an-sy/fhnw-iot-project-media-controller/05-Praesentation-Slides/IoT_Praesentation_Slides.pdf

# Senior Media Controller

# Iot-Projekt HS19

## Anas Syed, Ravindra Asirvatham

# Usecase

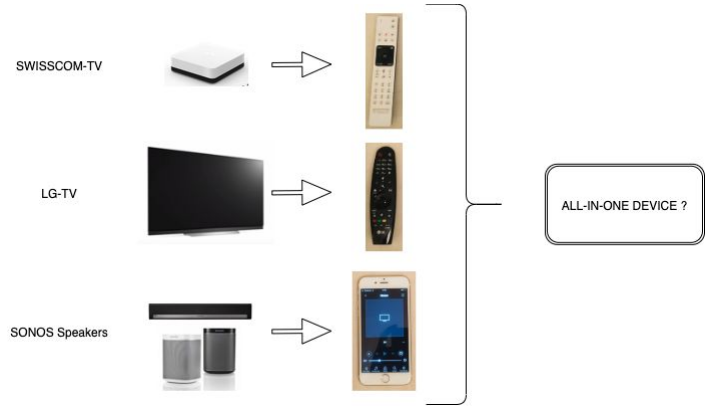
[picture p9: figure]

# Senior, 78, möchte seine Swisscom-TV und Sonos Lautsprecher Anlage mit einem einzigen Gerät bedienen

können.

### Senior Media Controller, IoT Project, HS19 by Anas Syed & Ravindra Asirvatham

# Referencemodel

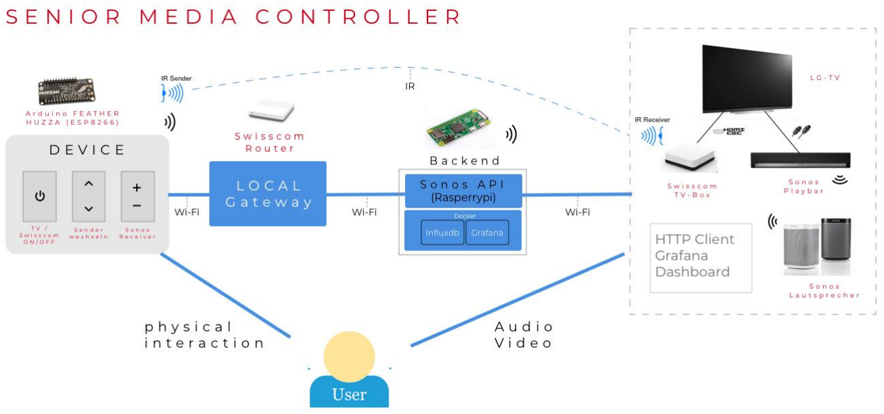
[picture p10: figure]

# Interface documentation

Sonos API Host: Sonos API Server Port: 5005 | | Contenttype: application/x-www-form-urlencoded requestBody: 'iotdevicelogs,method=changeVolume,status=ok value=20'
VALUE | = Volume

## GET /Fernsehzimmer/volume/VALUE

# IR Swisscom-TV - Arduino

## Protocoll: NEC Freq: 38khz

Power On/Off: | SwisscomPower[28] = { | 0x0000, | 0x006B, | 0x0000, | 0x000C, | 0x000C, | 0x0018, | 0x0018, | 0x0018, | 0x0018, | 0x0018,
0x0018, | 0x000C, | 0x000C, | 0x0018, | 0x0018, | 0x0018, | 0x000C, | 0x000C, | 0x000C, | 0x000C, | 0x0018, | 0x0018, | 0x0018, | 0x000C, | 0x000C,
0x0018, | 0x000C, | 0x0D58 | }
Program Up: | SwisscomProgUp[26] = { | 0x0000, | 0x006B, | 0x0000, | 0x000B, | 0x000C, | 0x0018, | 0x0018, | 0x0018, | 0x0018, | 0x0018,
0x0018, | 0x000C, | 0x000C, | 0x0018, | 0x0018, | 0x0018, | 0x000C, | 0x000C, | 0x0018, | 0x0018, | 0x0018, | 0x0018, | 0x000C, | 0x000C, | 0x0018,
0x0D64 | }
Program Down: SwisscomProgDown[26] = { 0x0000, 0x006B, 0x0000, 0x000B, 0x000C, 0x0018, 0x0018, 0x0018, 0x0018,

0x0018, 0x0018, 0x000C, 0x000C, 0x0018, 0x0018, 0x0018, 0x000C, 0x000C, 0x0018, 0x0018, 0x0018, 0x000C, 0x000C, 0x0018, 0x0018, 0x0D64 }

# InfluxDB API

## Host: InfluxDB Server Port: 8086 POST /write?db=iotdevicelogs

# Issues

# Keine Bluetooth API Dokus zur Swisscom-TV - Alternative: IR Dongles der Swisscom-TV

# Keine Dokus zur IR Codes - Swisscom-Community Blog

# Poti - Range - linear - offen
