an-sy/fhnw-iot-project-media-controller/04-Bilder/HDMI-CEC-Swisscom-LG.png

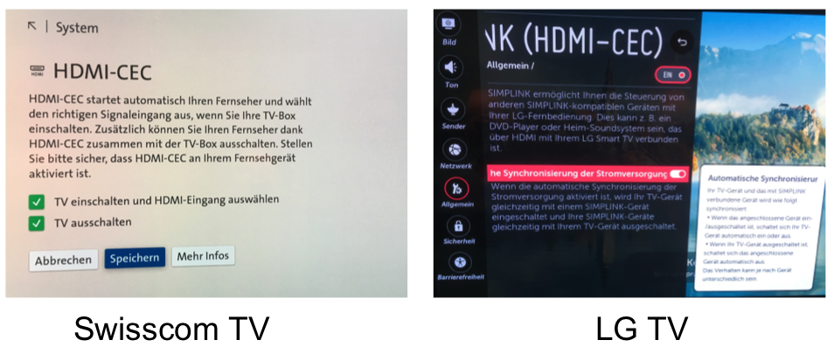
04-Bilder/HDMI-CEC-Swisscom-LG.png
