an-sy/fhnw-iot-project-media-controller/04-Bilder/HDMI-CEC_SwisscomTV.JPG

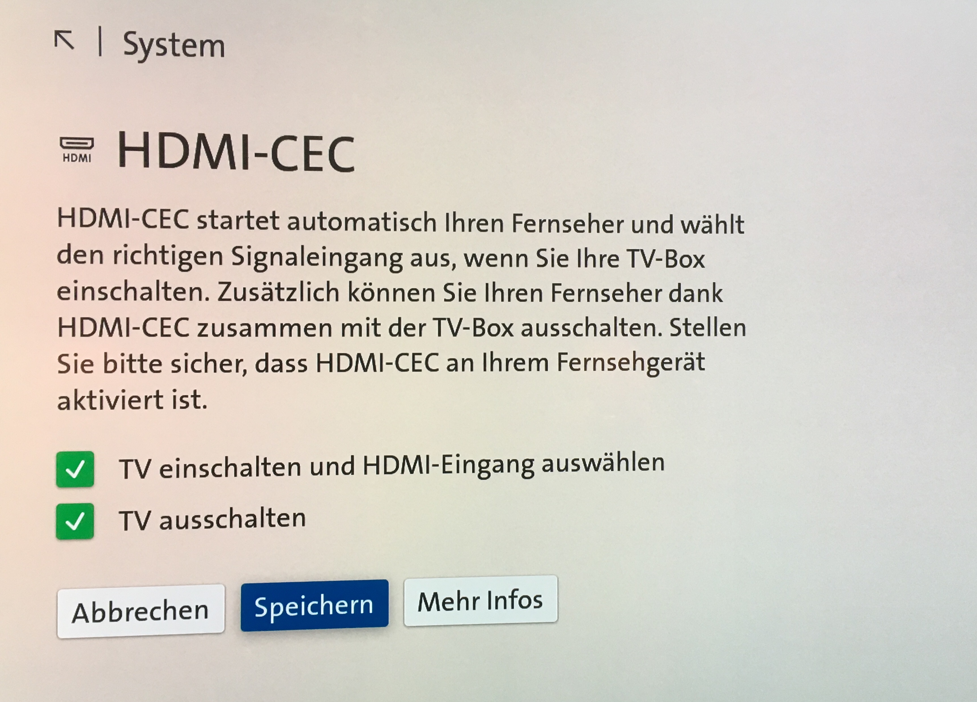
04-Bilder/HDMI-CEC_SwisscomTV.JPG
