an-sy/fhnw-iot-project-media-controller/02-Arduino/01_ESP8266_remote_Client_demo/config.h

//Sonos Server Config
#define sonosHost "192.168.0.101" // replace Sonos Server IP
#define sonosPort 5005 // replace Sonos Server port
#define sonosSpeakerPath "/fernsehzimmer/volume/" // replace Sonos Server Speakerpath

// influxDB Server
#define influxdbHost "192.168.0.105" 
#define influxdbPort 8086 // 
#define influxdbPath "/write?db=iotdevicelogs"


//Swisscom Ir Code
// https://community.swisscom.ch/t5/Nutzung/Swisscom-TV-2-0-Fernbedienung-IR-Codes/td-p/506017
uint16_t SwisscomPower[28] = { 0x0000, 0x006B, 0x0000, 0x000C, 0x000C, 0x0018, 0x0018, 0x0018, 0x0018, 0x0018, 0x0018, 0x000C, 0x000C, 0x0018, 0x0018, 0x0018, 0x000C, 0x000C, 0x000C, 0x000C, 0x0018, 0x0018, 0x0018, 0x000C, 0x000C, 0x0018, 0x000C, 0x0D58 };

uint16_t SwisscomProgUp[26] = { 0x0000, 0x006B, 0x0000, 0x000B, 0x000C, 0x0018, 0x0018, 0x0018, 0x0018, 0x0018, 0x0018, 0x000C, 0x000C, 0x0018, 0x0018, 0x0018, 0x000C, 0x000C, 0x0018, 0x0018, 0x0018, 0x0018, 0x000C, 0x000C, 0x0018, 0x0D64 };

uint16_t SwisscomProgDown[26] = { 0x0000, 0x006B, 0x0000, 0x000B, 0x000C, 0x0018, 0x0018, 0x0018, 0x0018, 0x0018, 0x0018, 0x000C, 0x000C, 0x0018, 0x0018, 0x0018, 0x000C, 0x000C, 0x0018, 0x0018, 0x0018, 0x000C, 0x000C, 0x0018, 0x0018, 0x0D64 };

uint16_t SwisscomMenu[26] = { 0x0000, 0x006B, 0x0000, 0x000B, 0x000C, 0x0018, 0x0018, 0x0018, 0x0018, 0x0018, 0x0018, 0x000C, 0x000C, 0x0018, 0x0018, 0x0018, 0x0018, 0x0018, 0x0018, 0x000C, 0x000C, 0x0018, 0x0018, 0x0018, 0x000C, 0x0D58 };
