an-sy/fhnw-iot-project-media-controller/02-Arduino/01_ESP8266_remote_Client_demo/.secrets.h

  
// Use this file to store all of the private credentials 
// and connection details

#define SECRET_SSID "MySSID"		// replace MySSID with your WiFi network name
#define SECRET_PASS "MyPassword"	// replace MyPassword with your WiFi password
