an-sy/fhnw-iot-project-media-controller/(commit log)

2019-11-23 first draw Wifi-Client Arduino
2019-12-14 moved arduino files to folder 02Arduino
2019-12-16 add Powerbutton
2019-12-24 created autostart sonos-api service on raspberrypi & it works
2020-01-06 arduino version at home
2020-01-11 fix log failure message
    [01_ESP8266_remote_Client_demo.ino]
2020-01-11 led state fixed
2020-01-11 update home arduino
2020-01-12 update arduino
2020-01-12 update arduino home version
2020-08-21 fixes links and cleanup
    [.secrets.h, config.h]
